pblfrnndmnr/control-bomba-isl1208-pic16-xc8/Control_BOMBA_RTC_ISL1208_V6.X/Cálculos/Cláculos de atrasos o adelantos del rtc.odt

El cristal utilizado es de Freq=32768Hz.

Para calcular la deriva en frecuencia se usa:

Deriva= (ppm*Freq)/1e6

Si se supone una variación de 20ppm

Deriva=20*32768/1000000=0,65536hz

Entonces la frecuencia es 32768,65536Hz

Para cada segundo el ideal sería contar 32768 ciclos, pero como se cuentan

0,65536 más, cada 32768/0,65536=50000 segundos tengo un segundo más,es decir que cada 50000/3600=13 horas tengo 1 segundo más, por lo tanto al cabo de un mes aproximadamente tengo un minuto.

Datos obtenidos:

Hora ajustada a las 22:22:00 del 14/02/15 con la hora de la pc. Ver cuanto atrasa.

con el rtc apagado

*a las 00:32

tenia 00:31:29

retraso 31 segundos

en 2horas 10min =>3974.36ppm

*a las 0:33 del 14/02/15

tenia 00:32:29 retraso 29 segundos en 2horas 11 min

=>3944ppm

*a las 11:18:08 del 15/02/15

tenia11:17:25 retraso 43 segundos

en 12horas 56min 8 segundos=>923.38ppm

*a las 16:44:38 del15/02/15

tenía 16:43:00

retraso 1min:38 seg =98seg

en 18horas 22min 38segundos=>1481.3ppm

*a las 11:53 del 16/02/15

tenia 11:51:14

retraso 1min:46seg=106seg

en 37horas 31 min=>784.83ppm

a las 11:01 del 17/02/15

tenía 10:59:08

retraso 1min:52seg=112seg

en 60horas 39min=>512.96ppm

*a las 14:48:27 del 10/03/15

tenia 14:46:00

retraso 2min:27seg=147seg

en 23dias 16horas 26minutos 27segundos=>2046387segundos=>71,83ppm

con el rtc apagado
