pblfrnndmnr/control-bomba-isl1208-pic16-xc8/(list of files, cad)

Other CAD files:
Control_BOMBA_RTC_ISL1208_V6.X/l.obj
