pblfrnndmnr/control-bomba-isl1208-pic16-xc8/(list of files, drawings)

Other design files:
Control_BOMBA_RTC_ISL1208_V6.X/Placas y simulaciones/Control_BOMBA_ISL1208.dsn
Control_BOMBA_RTC_ISL1208_V6.X/Placas y simulaciones/PLACAControl_BOMBA_ISL1208.dsn
Control_BOMBA_RTC_ISL1208_V6.X/Placas y simulaciones/PLACAControl_BOMBA_ISL1208.LYT
Control_BOMBA_RTC_ISL1208_V6.X/Placas y simulaciones/rectificador.dsn
Control_BOMBA_RTC_ISL1208_V6.X/Placas y simulaciones/Simulacion Control_BOMBA_ISL1208.dsn
