pblfrnndmnr/control-bomba-isl1208-pic16-xc8/Control_BOMBA_RTC_ISL1208_V6.X/user.h

#ifndef	_USER_H_
#define	_USER_H_
/******************************************************************************/
/* User Level #define Macros                                                  */
/******************************************************************************/

#define salidabomba RC0  //PORTCbits.RC0


//contadores para minutos segundos y horas
unsigned char cuentasegundos = 0, cuentaminutos = 0, cuentahoras = 0, cuentadias = 0;
unsigned char cuenta40ms;
unsigned char cuenta500ms;

#define TIEMPODEESPERA=10 //segundos
//unsigned char tiempoanterior = 0, tiempoactual = 0;
unsigned char activapwmpor;
//bool expirotiempo = 0;
/*  Application specific user parameters used in user.c may go here */


#define LCD 0
#define USART 1
//bandera para enviar por USART o por LCD
bool envia_por = LCD;
bool refrescadisplay = 0;
bool haycambio = 0;
bool flanco = 0;
bool actualizo_datos_rtc=0;
unsigned char tiempoapagadolcd=0; //en segundos
unsigned char tiemporegresaamenuinicial=0;
//Definiciones para indicar el inicio de la posicion de los datos del LCD
#define INICIOHORAS 1
#define INICIOMINUTOS INICIOHORAS+3
#define INICIODIA 1
#define INICIOMES INICIODIA+3
#define INICIOANIO INICIOMES+3

//constantes para saber que se esta modificando

#define HORA 0X00
#define MINUTOS 0X01
#define DIA 0X02
#define MES 0X03
#define ANIO 0X04
#define DIADELASEMANA 0X05
#define SINO 0x06
#define TIEMPOENCENDIDO 0x07
#define TIEMPOFALLA 0x08
#define PERIODOENCENDIDO 0X09
#define NOHACENADA 0x0A
//bandera para modificar minutos horas dia mes año
unsigned char modificafecha = NOHACENADA;
bool * banderasino;

//definicion de los datos para la fecha y horario

typedef union {//32bits
    unsigned long Valor;

    struct {
        unsigned char day;
        unsigned char month;
        unsigned char yr;
        unsigned char dow;
    };
} Fecha_t;

typedef union {//24bits
    unsigned short long Valor;

    struct {
        unsigned char sec;
        unsigned char min;
        unsigned char hrs;

    };
} Horario_t;

//ISL1208 Status Register (SR) - Address 07h

typedef union {//8bits
    unsigned char Valor;

    struct {
        unsigned RTCF : 1; //REAL TIME CLOCK FAIL BIT (RTCF)
        unsigned BAT : 1; //BATTERY BIT (BAT)
        unsigned ALM : 1; //ALARM BIT (ALM)
        unsigned : 1;
        unsigned WRTC : 1; //WRITE RTC ENABLE BIT (WRTC)
        unsigned : 1;
        unsigned XTOSCB : 1; //CRYSTAL OSCILLATOR ENABLE BIT (XTOSCB)
        unsigned ARST : 1; //AUTO RESET ENABLE BIT (ARST)

    };
} isl1208_SR_t;

//ISL1208 Interrupt Control Register (INT) - Address 08h

typedef union {//8bits
    unsigned char Valor;

    struct {
        unsigned FO : 4; //FREQUENCY OUT CONTROL BITS (FO <3:0>)
        unsigned FOBATB : 1; //FREQUENCY OUTPUT AND INTERRUPT BIT (FOBATB)
        unsigned LPMODE : 1; //LOW POWER MODE BIT (LPMODE)
        unsigned ALME : 1; //ALARM ENABLE BIT (ALME)
        unsigned IM : 1; //INTERRUPT/ALARM MODE BIT (IM)
    };
} isl1208_INT_t;



Fecha_t fecha;
Fecha_t fechaenc;
Horario_t * horario;
Horario_t horarioenc;
Horario_t horarioactual;
Horario_t horarioapagado;
Horario_t tiemporestantehora;
unsigned char tiemporestantedias;
isl1208_SR_t isl1208SR;
isl1208_INT_t isl1208INT;

char cadenaamostrar[9];
char cadenaamostrar2[9];

float mediciondecorriente;
float mediciondevoltaje;
unsigned int adcenteroV;
signed int adcenteroI;
signed int adcdecimalI;
//Definicion de las entradas del menu
#define MENU_INICIAL 0 //el menu donde se puede cambiar de manual a automatico y donde se puede encender la bomba en manual
#define MENU_MUESTRAHORA_FECHA 1 //muestra la hora actual y el estado de la bomba, encendido apagado o falla de sobrecorriente, nivel bajo
//#define MENU_MUESTRAFECHA  //muestra la fecha actual
#define MENU_MUESTRAMEDICIONES 2 //menu que muestra la medicion de corriente de motor y tension
//#define MENU_CONFIGURAHORARIO 3 //menu para configurar el horario
//#este menu tiene submenu
#define SUBMENU_CONFIGURAHORA 3 //submenu para configurar la hora
#define SUBMENU_CONFIGURAMINUTOS 4 //submenu para configurar los minutos

//#define MENU_CONFIGURAFECHA 5 //menu para configurar la fecha
//#este menu tiene submenu
#define SUBMENU_CONFIGURADIA 5 //submenu para configurar el dia
#define SUBMENU_CONFIGURAMES 6 //submenu para configurar el mes
#define SUBMENU_CONFIGURAANIO 7 //submenu para configurar el año


//#define MENU_CONFIGURAENCENDIDO 8 //menu para configurar la hora de encendido de la bomba
//#este menu tiene submenu
#define SUBMENU_CONFIGURAHORAENCENDIDO 8 //submenu para configurar la hora de encendido
#define SUBMENU_CONFIGURAMINUTOSENCENDIDO 9 //submenu para configurar la hora de encendido
#define SUBMENU_CONFIGURATIEMPOENCENDIDO 10 //submenu para configurar el tiempo en que la bomba está encendida, con un maximo de 1hora
#define SUBMENU_CONFIGURAPERIODOENCENDIDO 11 //submenu para indicar cada cuantos dias se prende la bomba


#define MENU_CONFIGURAFALLACORRIENTE 12//se indica si la entrada de falla de corriente es por contacto NC=1 o NA=0
#define MENU_CONFIGURATIEMPOFALLACORRIENTE 13 //se configura el tiempo en que la falla esta activa para parar el motor, maximo 30segundos


#define ULTIMOMENU 13 //indica el valor del ultimo menu

#define TIEMPOMAXIMOENCENDIDO 60 //minutos
#define TIEMPOMAXIMOFALLA 10 //segundos
#define TIEMPOMAXIMONIVEL 15 //es el tiempo en segundos que hay que esperar en caso de que se llegue al nivel minimo para apagar el motor
#define TIEMPOMAXIMOPERIODO 6 //cada cuantos dias se riega.
unsigned char periodoencendido = 0;
unsigned char tiempoencendido = 0;
bool usa_falla_de_corriente = 0;
bool indica_tiempo_falla = 0;
unsigned char tiempofalla = 0;
unsigned char cuenta_tiempofalla = 0;
#define NOHUBOFALLA 0
#define HUBOFALLACORRIENTE 1
#define HUBOFALLAVOLTAJE 2
#define HUBOFALLANIVEL 3
#define HUBOFALLARTC 4
unsigned char ultimafalla= NOHUBOFALLA;
#define FALLAPRESENTE 0
#define FALLARESETEADA 1
bool reseteafallas=FALLARESETEADA;
unsigned char menuactual = MENU_INICIAL;

//Variables para procesar la secuencia de arranque
bool indica_secuencia_arranque = 0;
#define TIEMPOSECUENCIAARRANQUE 10 //TODO ajustar el tiempo de secuencia de arranque
unsigned char tiempo_secuencia_arranque = 0;
bool bandera_orden_on_off_bomba = 0;
bool bandera_orden_Alarma_bomba=0;
///
bool bandera_graba_hora = 0; //bandera para grabar la hora
bool bandera_graba_fecha = 0; //bandera para grabar la fecha
bool bandera_graba_global = 0; //bandera que habilita el grabago de datos cuando se pulsa el boton BOTON_ONOFF
bool bandera_graba_manual_automatico=0; //bander aque habilita el grabado de manual o automatico en eeprom
bool bandera_graba_periodoytiempoencendido = 0;
//bool bandera_graba_tiempoencendido = 0;
bool bandera_graba_usa_falla_de_corriente = 0;
bool bandera_graba_tiempofalla = 0;
//constantes y variables de indicacion del estado de la bomba
#define APAGABOMBA 0
#define ENCIENDEBOMBA 1
bool activabomba = APAGABOMBA;

#define BOMBAAPAGADA 0
#define BOMBAENCENDIDA 1
bool estadobomba = BOMBAAPAGADA;
#define NIVELNORMAL 1
#define NIVELBAJO 0
bool estadonivel = NIVELNORMAL;
#define CORRIENTENORMAL 1
#define FALLACORRIENTE 0
bool estadofallacorriente = CORRIENTENORMAL;
#define VOLTAJENORMAL 1
#define FALLAVOLTAJE 0
bool estadofallavoltaje = FALLAVOLTAJE;
#define MANUAL 0
#define AUTOMATICO 1
bool manual_automatico;

#define NOALARMA 0
#define SIALARMA 1
bool alarma_encendido = NOALARMA;

unsigned int medidaI_adc = 0;
#define OFFSET_I .1
unsigned int medidaV_adc = 0;
bool cambio_de_canal = 0;
//int promedio_adc[4] = {0, 0, 0, 0};

#define VOLTAJEMAXIMO 240
#define VOLTAJEMINIMO 190
#define CORRIENTEMAXIMA 23.0 //AMPERES //TODO depende de la corriente consumida por el motor
//#define CORRIENTEMINIMA 1.0 //AMPERES
#define CORRIENTENORMALMAXIMA 8.0 //AMPERES //TODO DEPENDE DE LA CORRIENTE CONSUMIDA POR EL MOTOR
#define CORRIENTENORMALMINIMA 1.0 //AMPERES //TODO DEPENDE DE LA CORRIENTE CONSUMIDA POR EL MOTOR
/******************************************************************************/
/* User Function Prototypes                                                   */
/******************************************************************************/

/* User level functions prototypes (i.e. InitApp) go here */
void InitApp(void); /* I/O and Peripheral Initialization */
void putch(char data);

#endif
