pblfrnndmnr/control-bomba-isl1208-pic16-xc8/Control_BOMBA_RTC_ISL1208_V6.X/pwm.h

#ifndef PWM_H
#define PWM_H
/* 
 * File:   PWM.h
 * Author: fernando
 *
 * Created on 16 de julio de 2014, 22:32
 */
void set_periodo_buzzer(void);
void set_duty(unsigned int duty);
void buzzer_on(unsigned char tiempo);
void buzzer_off(void);

#endif
