pblfrnndmnr/control-bomba-isl1208-pic16-xc8/Control_BOMBA_RTC_ISL1208_V6.X/usart1.h

#ifndef	_USART_H_
#define	_USART_H_

/* 
 * File:   usart.h
 * Author: fernando
 *
 * Created on 29 de abril de 2014, 22:37
 */
#include "system.h"
#define baudrate 2400

void configura_USART (void);
void putch(char data);
char getch(void) ;
bit kbhit(void);



#endif
