pblfrnndmnr/control-bomba-isl1208-pic16-xc8/Control_BOMBA_RTC_ISL1208_V6.X/system.c

/******************************************************************************/
/*Files to Include                                                            */
/******************************************************************************/

#if defined(__XC)
    #include <xc.h>         /* XC8 General Include File */
#elif defined(HI_TECH_C)
    #include <htc.h>        /* HiTech General Include File */
#endif

#include "system.h"

/* Refer to the device datasheet for information about available
oscillator configurations. */
void ConfigureOscillator(void)
{
    /* Add clock switching code if appropriate.  */

    /* Typical actions in this function are to tweak the oscillator tuning
    register, select new clock sources, and to wait until new clock sources
    are stable before resuming execution of the main project. */
}
