pblfrnndmnr/control-bomba-isl1208-pic16-xc8/(commit log)

2015-01-05 Primera subida
    [Control_BOMBA_ISL1208.dsn, PLACAControl_BOMBA_ISL1208.LYT, PLACAControl_BOMBA_ISL1208.dsn, Simulacion Control_BOMBA_ISL1208.dsn, l.obj, rectificador.dsn]
2015-01-12 Cambiado start por rstart en _isl1208.c Cambiado |R_nW por||R_nW en HardI2C.c
    [Simulacion Control_BOMBA_ISL1208.dsn, l.obj]
2015-01-17 Primera subida con la hora y fecha funcionando a medias
    [Simulacion Control_BOMBA_ISL1208.dsn, l.obj]
2015-01-17 Primera subida con la hora y fecha funcionando
    [l.obj]
2015-01-18 Agregado lectura y escritura del día de la semana en la fecha
    [l.obj]
2015-01-18 Acomodando un poco el código
    [l.obj]
2015-01-18 En caso de corte totatl de energia del rtc, se carga la fecha inicial con el jueves 1/1/15. Agregado cada cuantos dias se desea encender la bomba.
    [l.obj]
2015-01-19 En caso de corte totatl de energia del rtc, se carga la fecha inicial con el jueves 1/1/15. Agregado cada cuantos dias se desea encender la bomba funcionando cambiado el antirrebote de 20 a 50
2015-01-24 Empiezo a verificar las condiciones de falla para poder activar la bomba
    [l.obj]
2015-01-24 Empiezo a verificar las condiciones de falla para poder activar la bomba, todavia no funciona
    [l.obj]
2015-01-25 Uso de code folding personalizado "fcom ", para formatear y entender mejor el código
    [l.obj]
2015-01-26 Empiezo a dtectar la alarma y procesar para encender la bomba con el RTC
    [l.obj]
2015-01-27 Se separan las condiciones para grabar los datos del RTC, se graba solo lo qu se cambia
    [l.obj]
2015-01-27 Se graban las configuraciones en la EEPROM del pic
    [l.obj]
2015-01-29 Quitando partes de código innecesarias
    [l.obj]
2015-01-30 Agregado secuencia de arranque, todavía no está probado si funciona o no.
    [l.obj]
2015-01-30 Agregado secuencia de arranque, todavía no funciona.
    [l.obj]
2015-01-30 Agregado secuencia de arranque, va queriendo funcionar para manual.
    [l.obj]
2015-01-30 Agregado secuencia de arranque, va queriendo funcionar para manual. Unificando las mediciones de tensión y corriente
    [l.obj]
2015-01-30 Agregado secuencia de arranque, no probado si funciona para automático.
    [l.obj]
2015-01-31 Agregado secuencia de arranque, va queriendo para automático. Quitado la configuracion de minutos de encendido, solamente se puede encender la bomba en automático, a las horas en punto.
    [l.obj]
2015-01-31 Agregado secuencia de arranque, va queriendo para automático. Quitado la configuracion de minutos de encendido, solamente se puede encender la bomba en automático, a las horas en punto. Quitado la op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
    [l.obj]
2015-01-31 Agragada condicion para qe si esta en automatico no haga caso a la pulsasion on_off de manual y viceversa. Esto es para solucionar el problema de que si se activaba la alarma cuando estaba en manual 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
    [interrupts.c, main.c]
2015-01-31 Arreglados los tiempos que cuentan el tiempo de falla y secuencia de arranque en segundos
    [interrupts.c, main.c, user.h]
2015-01-31 La actualización del display ahora se produce cada vez que hay un cambio en los datos a mostrar con haycambio y refrescadisplay, no esta probado si funciona
    [l.obj]
2015-02-01 La actualización del display ahora se produce cada vez que hay un cambio en los datos a mostrar con haycambio y refrescadisplay, no actualiza corrextamente, funciona igual que antes
2015-02-01 Agregando agradecimientos a los códigos reutilizados
    [l.obj]
2015-02-01 Actualizacion de hora y fecha cada 1 segundo.
2015-02-01 Actualizacion de hora y fecha cada 1 segundo, cuando flanco=0
2015-02-01 Actualizacion de hora y fecha cada 1 segundo, cuando flanco=0, no probado Agregado nuevamente los minutos en el horario de encendido de la bomba, queda un poco mejor.
2015-02-01 Actualizacion de hora y fecha cada 1 segundo, cuando flanco=0, no probado Agregado nuevamente los minutos en el horario de encendido de la bomba, queda un poco mejor. Agregado timepoapagado, para apa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
2015-02-02 Actualizacion de hora y fecha cada 1 segundo, cuando flanco=0, funcionando Agregado nuevamente los minutos en el horario de encendido de la bomba, queda un poco mejor. Agregado timepoapagado, para ap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
    [l.obj]
2015-02-02 Actualizacion de hora y fecha cada 1 segundo, cuando flanco=0, funcionando Agregado nuevamente los minutos en el horario de encendido de la bomba, queda un poco mejor. Agregado timepoapagado, para ap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
    [interrupts.c, main.c, pwm.c, pwm.h]
2015-02-03 Actualizacion de hora y fecha cada 1 segundo, cuando flanco=0, funcionando Agregado nuevamente los minutos en el horario de encendido de la bomba, queda un poco mejor. Agregado timepoapagado, para ap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
    [interrupts.c, main.c, user.h]
2015-02-03 Actualizacion de hora y fecha cada 1 segundo, cuando flanco=0, funcionando Agregado nuevamente los minutos en el horario de encendido de la bomba, queda un poco mejor. Agregado timepoapagado, para ap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
    [main.c, user.h]
2015-02-05 Actualizacion de hora y fecha cada 1 segundo, cuando flanco=0, funcionando Agregado nuevamente los minutos en el horario de encendido de la bomba, queda un poco mejor. Agregado timepoapagado, para ap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
    [l.obj]
2015-02-06 Actualizacion de hora y fecha cada 1 segundo, cuando flanco=0, funcionando Agregado nuevamente los minutos en el horario de encendido de la bomba, queda un poco mejor. Agregado timepoapagado, para ap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
    [l.obj]
2015-02-06 Actualizacion de hora y fecha cada 1 segundo, cuando flanco=0, funcionando Agregado nuevamente los minutos en el horario de encendido de la bomba, queda un poco mejor. Agregado timepoapagado, para ap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
    [l.obj]
2015-02-07 Agregada el encendido de la bomba todos los dias o cada 2,3,4,5,6,7 dias. No probado Version casi final. 0.3 ram usada: 207 de 368 (56%) flash usada: 6882 de 8192 (84%)
    [l.obj]
2015-02-07 Agregada el encendido de la bomba todos los dias o cada 2,3,4,5,6,7 dias y mejorado un poco. No probado
    Version casi final. 0.4
    ram usada: 207 de 368 (56%)
    flash usada: 6865 de 8192 (84%)
    [l.obj]
2015-02-07 Agregada el encendido de la bomba todos los dias o cada 2,3,4,5,6,7 dias y mejorado un poco. No probado
    flash usada: 6834 de 8192 (83%)
    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
2015-02-07 Agregada el encendido de la bomba todos los dias o cada 2,3,4,5,6,7 dias y mejorado un poco. No probado
    flash usada: 6865 de 8192 (83%)
    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
    [l.obj]
2015-02-07 Agregada el encendido de la bomba todos los dias o cada 2,3,4,5,6,7 dias y mejorado un poco. No probado
    flash usada: 6835 de 8192 (83%)
    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
2015-02-07 Agregada el encendido de la bomba todos los dias o cada 2,3,4,5,6,7 dias y mejorado un poco. No probado Agregado el MENU_INICIAL, donde solamente se puede cambiar entre manual y automatico y encender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
    [l.obj]
2015-02-07 Agregada el encendido de la bomba todos los dias o cada 2,3,4,5,6,7 dias y mejorado un poco. No probado Agregado el MENU_INICIAL, donde solamente se puede cambiar entre manual y automatico y encender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
2015-02-08 Agregada el encendido de la bomba todos los dias o cada 2,3,4,5,6,7 dias y mejorado un poco. No probado Agregado el MENU_INICIAL, donde solamente se puede cambiar entre manual y automatico y encender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
2015-02-08 Agregada el encendido de la bomba todos los dias o cada 2,3,4,5,6,7 dias y mejorado un poco. No probado Quitado muestra del dia de la semana,( no se muestra), solo se calcula y se usa para activar la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
    [l.obj]
2015-02-08 Agregada el encendido de la bomba todos los dias o cada 2,3,4,5,6,7 dias y mejorado un poco. No probado Unificados varios menu para mostrar los datos en dos lineas. Funcionando Agregado el uso o no d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
    [l.obj]
2015-02-08 Agregada el encendido de la bomba todos los dias o cada 2,3,4,5,6,7 dias y mejorado un poco. No probado Agregado el uso o no de la falla de corrriente. No probado Agregado la indicación de la última 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
    [interrupts.c, main.c, user.h]
2015-02-08 Agregada el encendido de la bomba todos los dias o cada 2,3,4,5,6,7 dias y mejorado un poco. No probado Agregado el uso o no de la falla de corrriente. No probado Agregado el offset de corriente para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
    [l.obj]
2015-02-08 Agregada el encendido de la bomba todos los dias o cada 2,3,4,5,6,7 dias y mejorado un poco. No probado Agregado el uso o no de la falla de corrriente. No probado Agregado el offset de corriente para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
    [l.obj]
2015-02-09 Agregada el encendido de la bomba todos los dias o cada 2,3,4,5,6,7 dias y mejorado un poco. No probado Agregado el uso o no de la falla de corrriente. No probado Agregado el offset de corriente para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
    [l.obj]
2015-02-09 Agregada el encendido de la bomba todos los dias o cada 2,3,4,5,6,7 dias y mejorado un poco. No probado Agregado el uso o no de la falla de corrriente. No probado Agregado el offset de corriente para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
    [l.obj]
2015-02-14 Agregada el encendido de la bomba todos los dias o cada 2,3,4,5,6,7 dias y mejorado un poco. No probado Agregado el uso o no de la falla de corrriente. No probado Agregado el offset de corriente para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
    [l.obj]
2015-02-14 Agregada el encendido de la bomba todos los dias o cada 2,3,4,5,6,7 dias y mejorado un poco. No probado Agregado el uso o no de la falla de corrriente. No probado Agregado el offset de corriente para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
    [main.c, user.h]
2015-02-15 Agregada el encendido de la bomba todos los dias o cada 2,3,4,5,6,7 dias y mejorado un poco. No probado Agregado el uso o no de la falla de corrriente. No probado Agregado el offset de corriente para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
    [main.c]
2015-02-15 Agregada el encendido de la bomba todos los dias o cada 2,3,4,5,6,7 dias y mejorado un poco. No probado Agregado el uso o no de la falla de corrriente. No probado Agregado el offset de corriente para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
    [main.c, user.h]
2015-03-30 Agregada el encendido de la bomba todos los dias o cada 2,3,4,5,6,7 dias y mejorado un poco. No probado Agregado el uso o no de la falla de corrriente. No probado Agregado la muestra del tiempo resta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
    [l.obj]
